tsipa/mh20-probe/hardware/pcb/check/report.txt

KiCad DRC (receiver_carrier.kicad_pcb): 0 item(s)
Extra checks: 0 violation(s)
Info: board_mm 98.00 x 70.00, vias 1, track_mm B.Cu=391.1 F.Cu=470.6, bodies 19
RESULT: PASS
