tsipa/mh20-probe/docs/images/no-probe.png

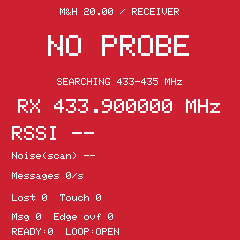
docs/images/no-probe.png
