tsipa/mh20-probe/docs/images/ready.png

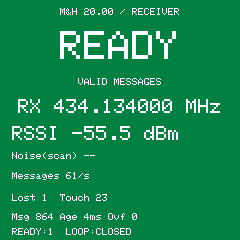
docs/images/ready.png
