tsipa/mh20-probe/hardware/pcb/preview/receiver_carrier-B_Cu.png

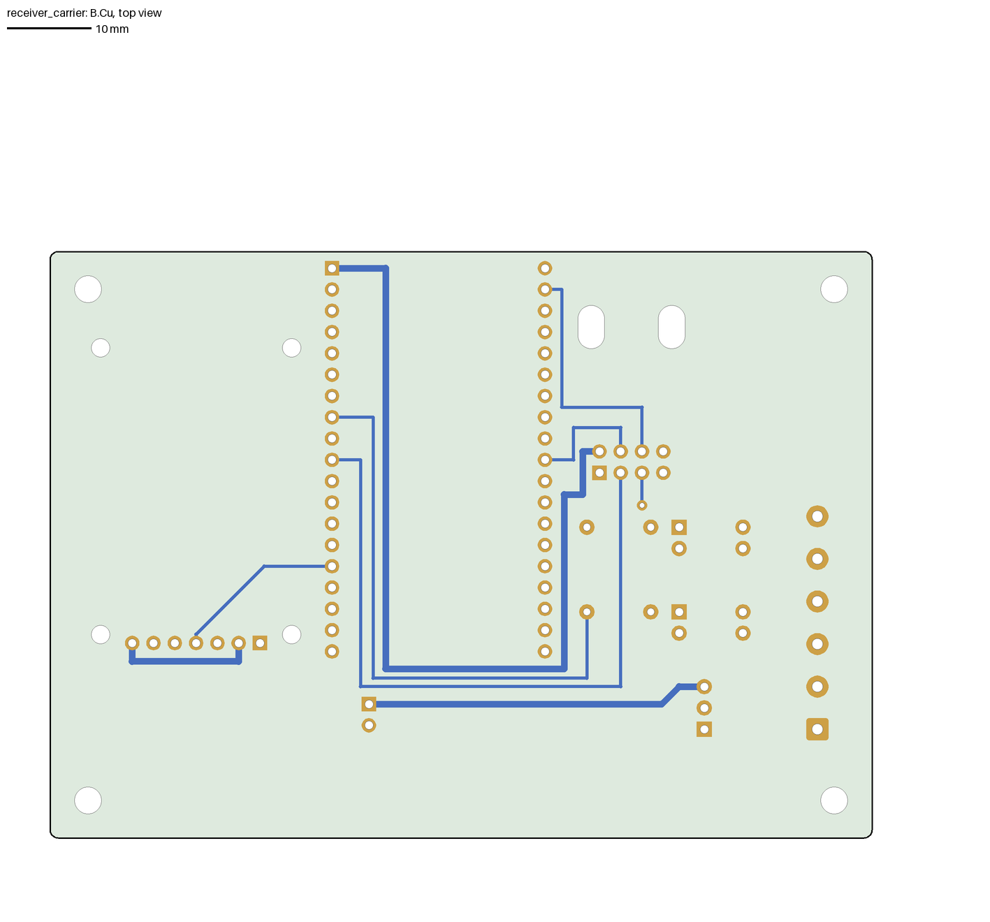
hardware/pcb/preview/receiver_carrier-B_Cu.png
