tsipa/mh20-probe/hardware/pcb/preview/receiver_carrier-back.png

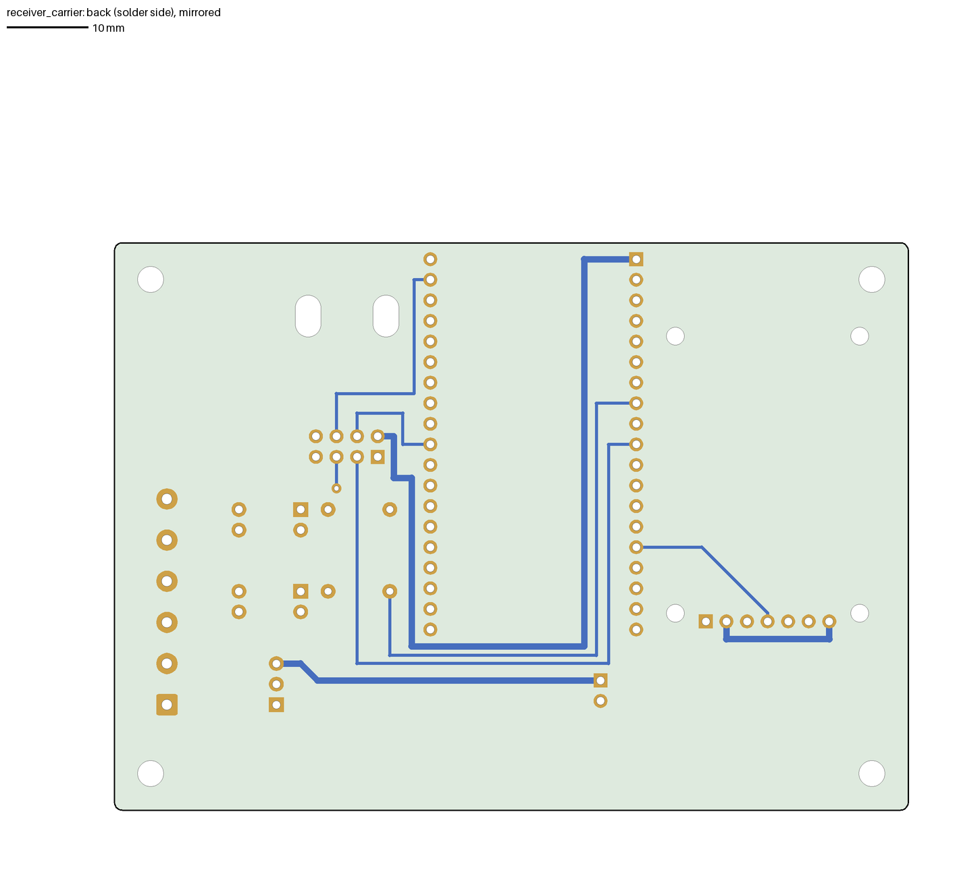
hardware/pcb/preview/receiver_carrier-back.png
