tsipa/mh20-probe/hardware/pcb/preview/receiver_carrier-F_Cu.png

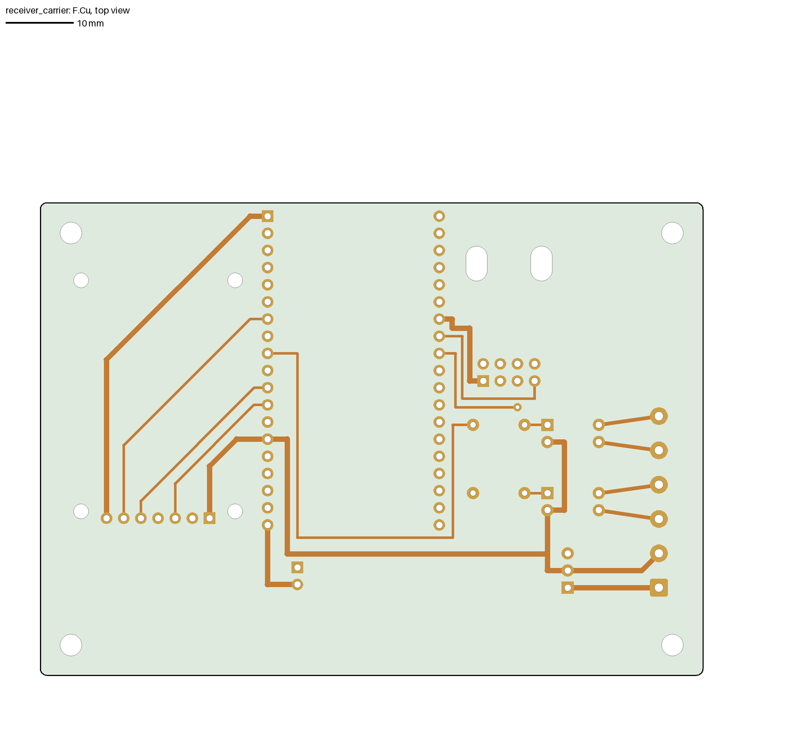
hardware/pcb/preview/receiver_carrier-F_Cu.png
