tsipa/mh20-probe/hardware/pcb/sources/CC1101-Product-size-600x313.jpg

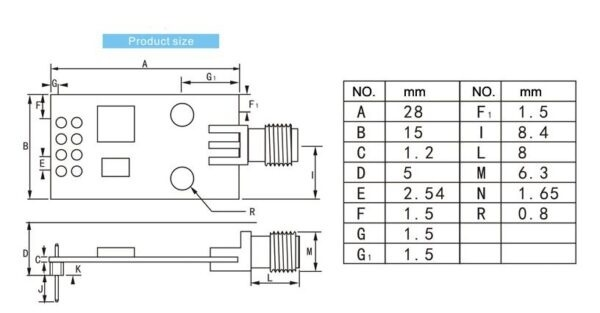
hardware/pcb/sources/CC1101-Product-size-600x313.jpg
