tsipa/mh20-probe/hardware/pcb/sources/er-tftm013-1_outline.webp

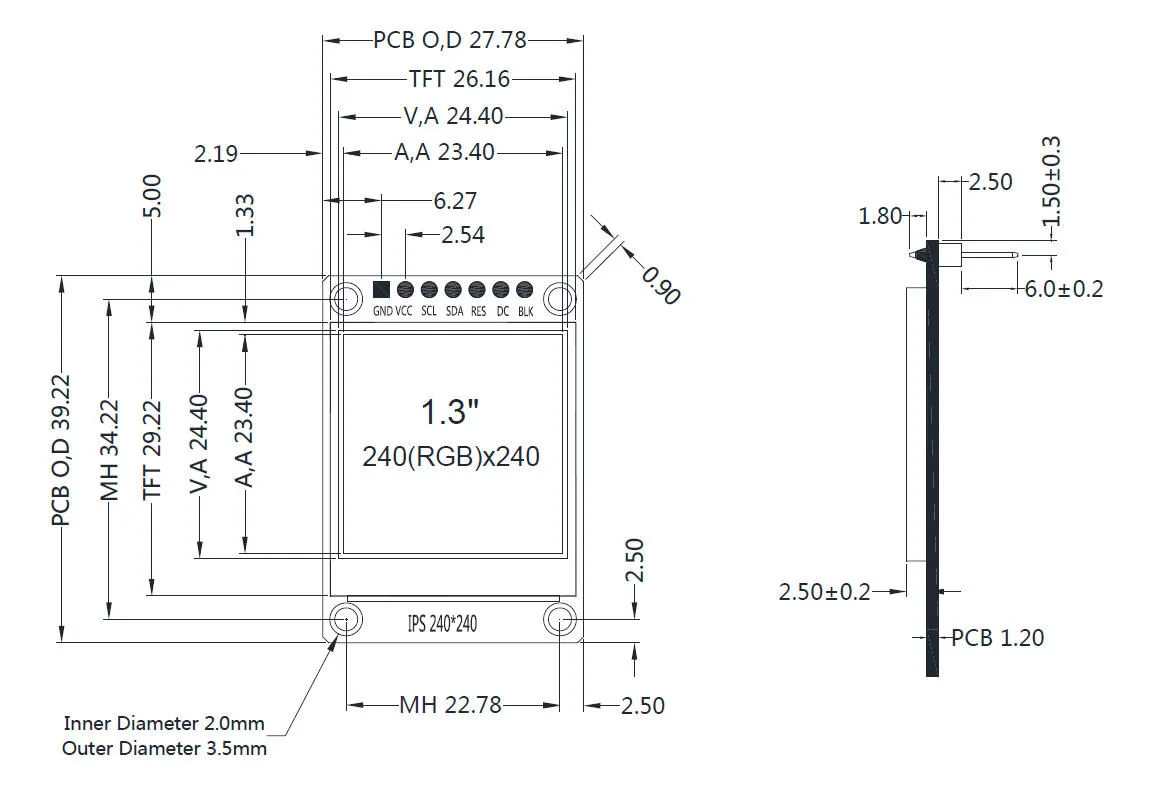
hardware/pcb/sources/er-tftm013-1_outline.webp
