tsipa/mh20-probe/hardware/pcb/sources/rf-ebyte-photo.jpg

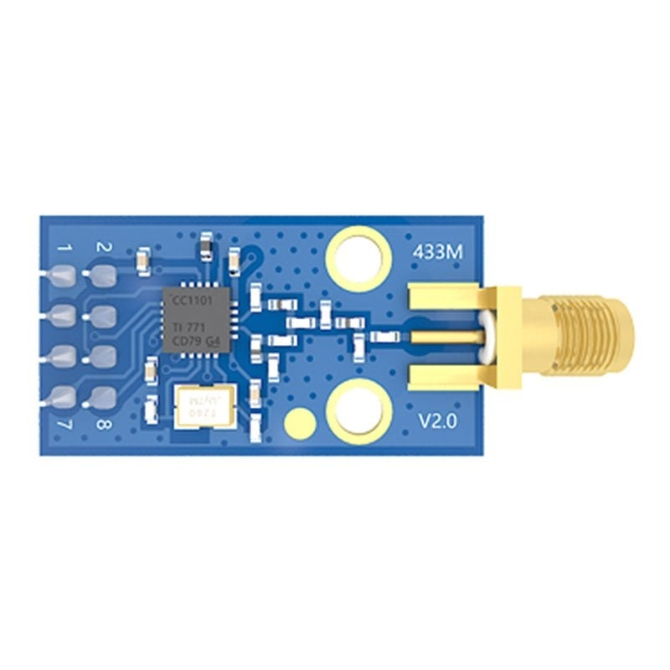
hardware/pcb/sources/rf-ebyte-photo.jpg
