tsipa/mh20-probe/hardware/pcb/sources/rf-spec-0.jpg

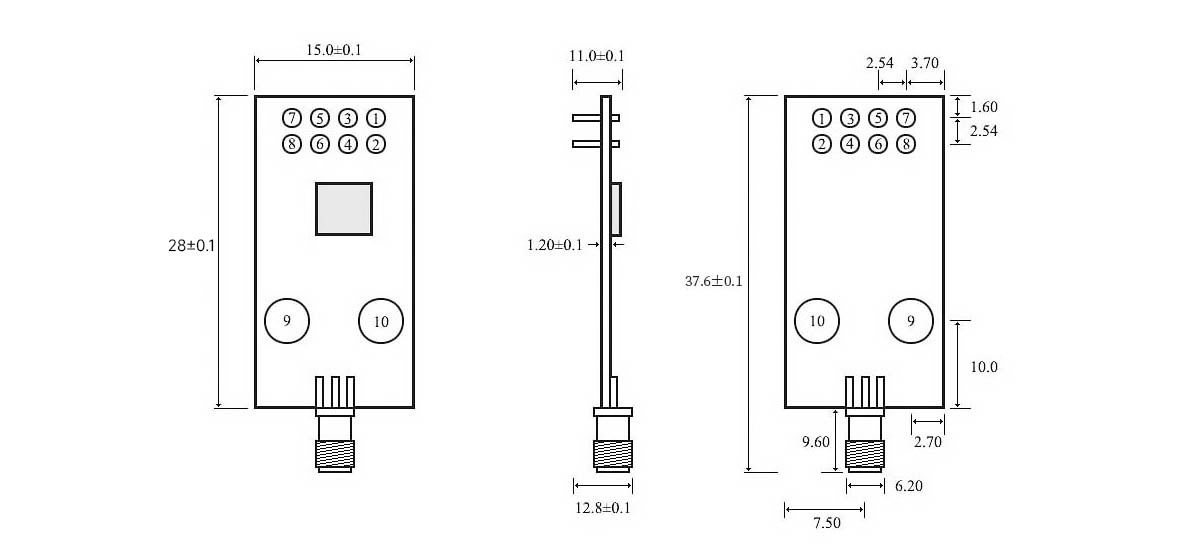
hardware/pcb/sources/rf-spec-0.jpg
