tsipa/mh20-probe/docs/images/wiring.png

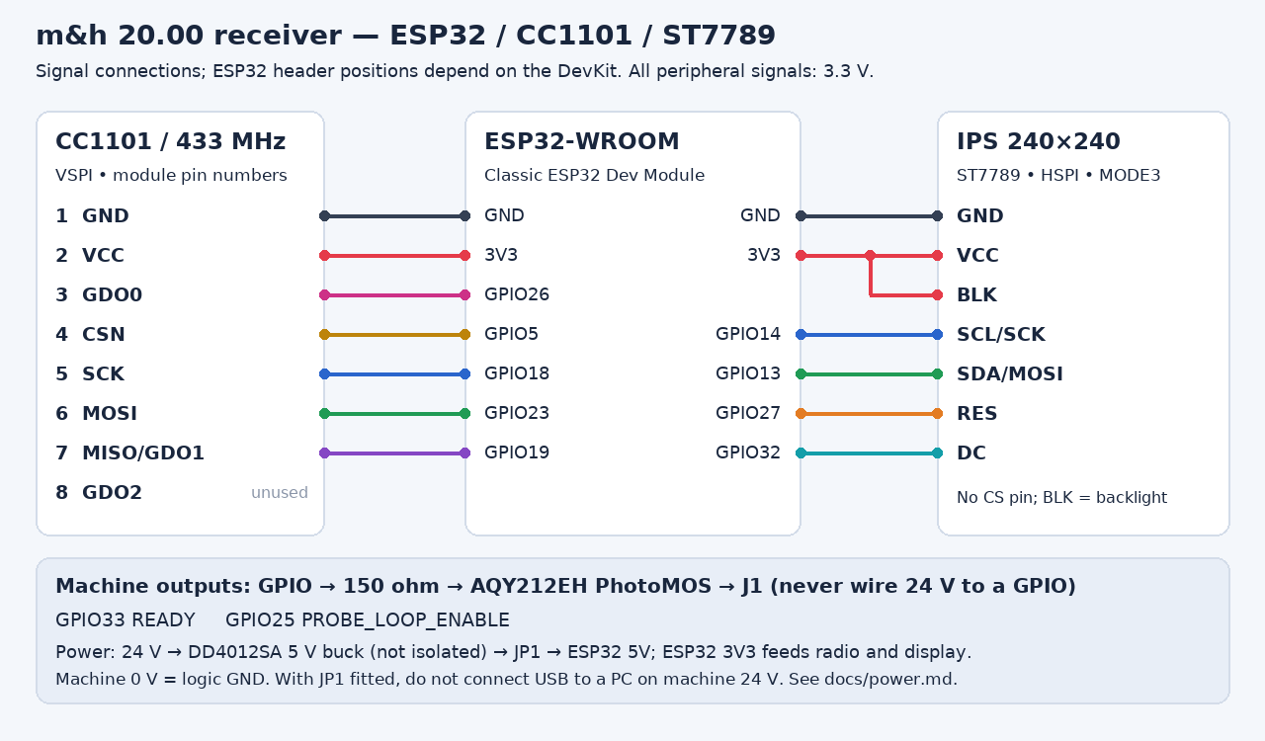
docs/images/wiring.png
