tsipa/mh20-probe/hardware/pcb/print/receiver_carrier-front-1to1.pdf

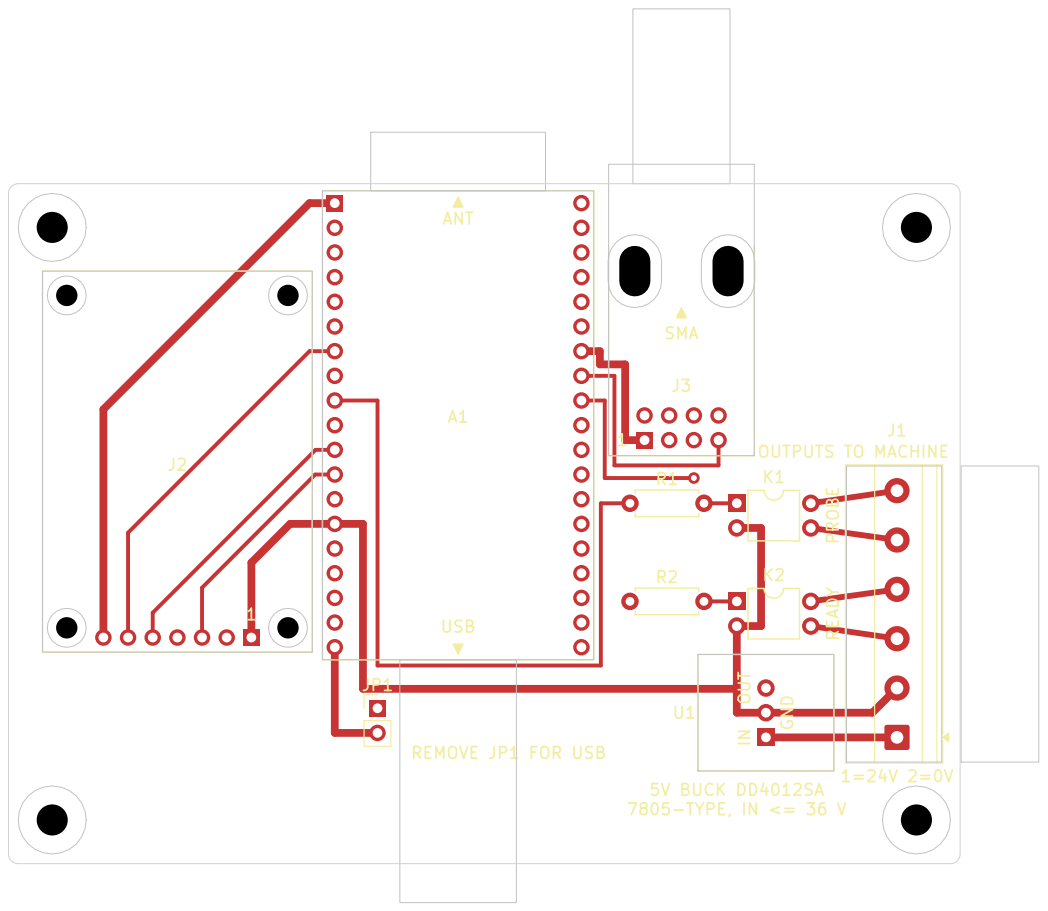
[picture p18: page 1]

5V BUCK DD4012SA 7805-TYPE, IN <= 36 V OUTPUTS TO MACHINE 1=24V 2=0V PROBE READY K2K1
