tsipa/mh20-probe/hardware/pcb/print/receiver_carrier-print-1to1.pdf

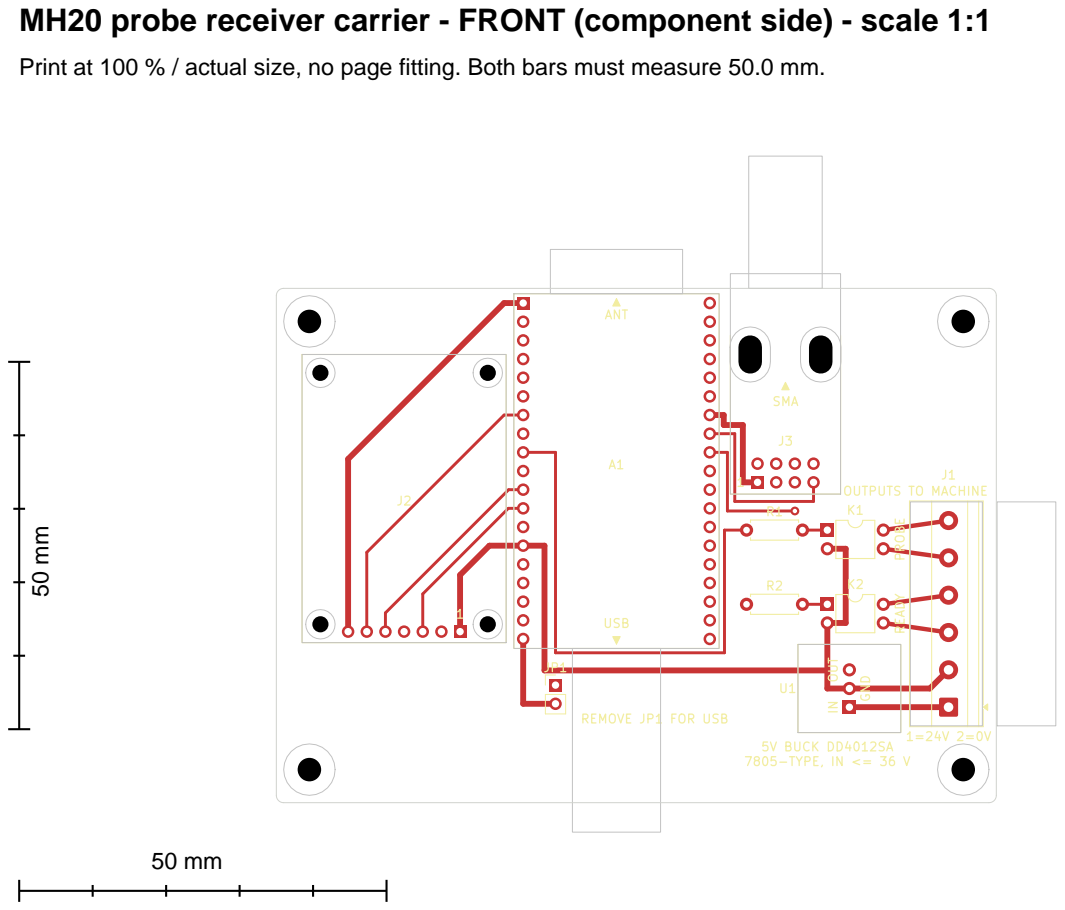
[picture p19: page 1]

MH20 probe receiver carrier - FRONT (component side) - scale 1:1

Print at 100 % / actual size, no page fitting. Both bars must measure 50.0 mm.

5V BUCK DD4012SA 7805-TYPE, IN <= 36 V OUTPUTS TO MACHINE 1=24V 2=0V PROBE READY K2K1

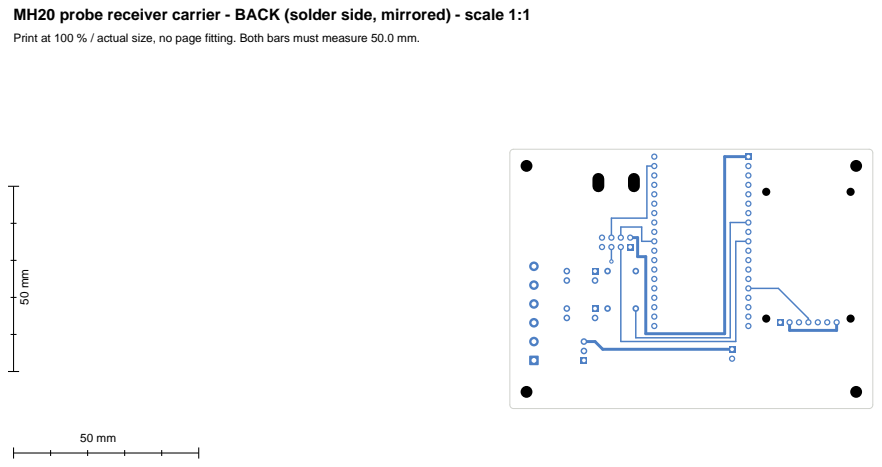
[picture p20: page 2]

MH20 probe receiver carrier - BACK (solder side, mirrored) - scale 1:1

Print at 100 % / actual size, no page fitting. Both bars must measure 50.0 mm.
