tsipa/mh20-probe/hardware/pcb/print/receiver_carrier-schematic.pdf

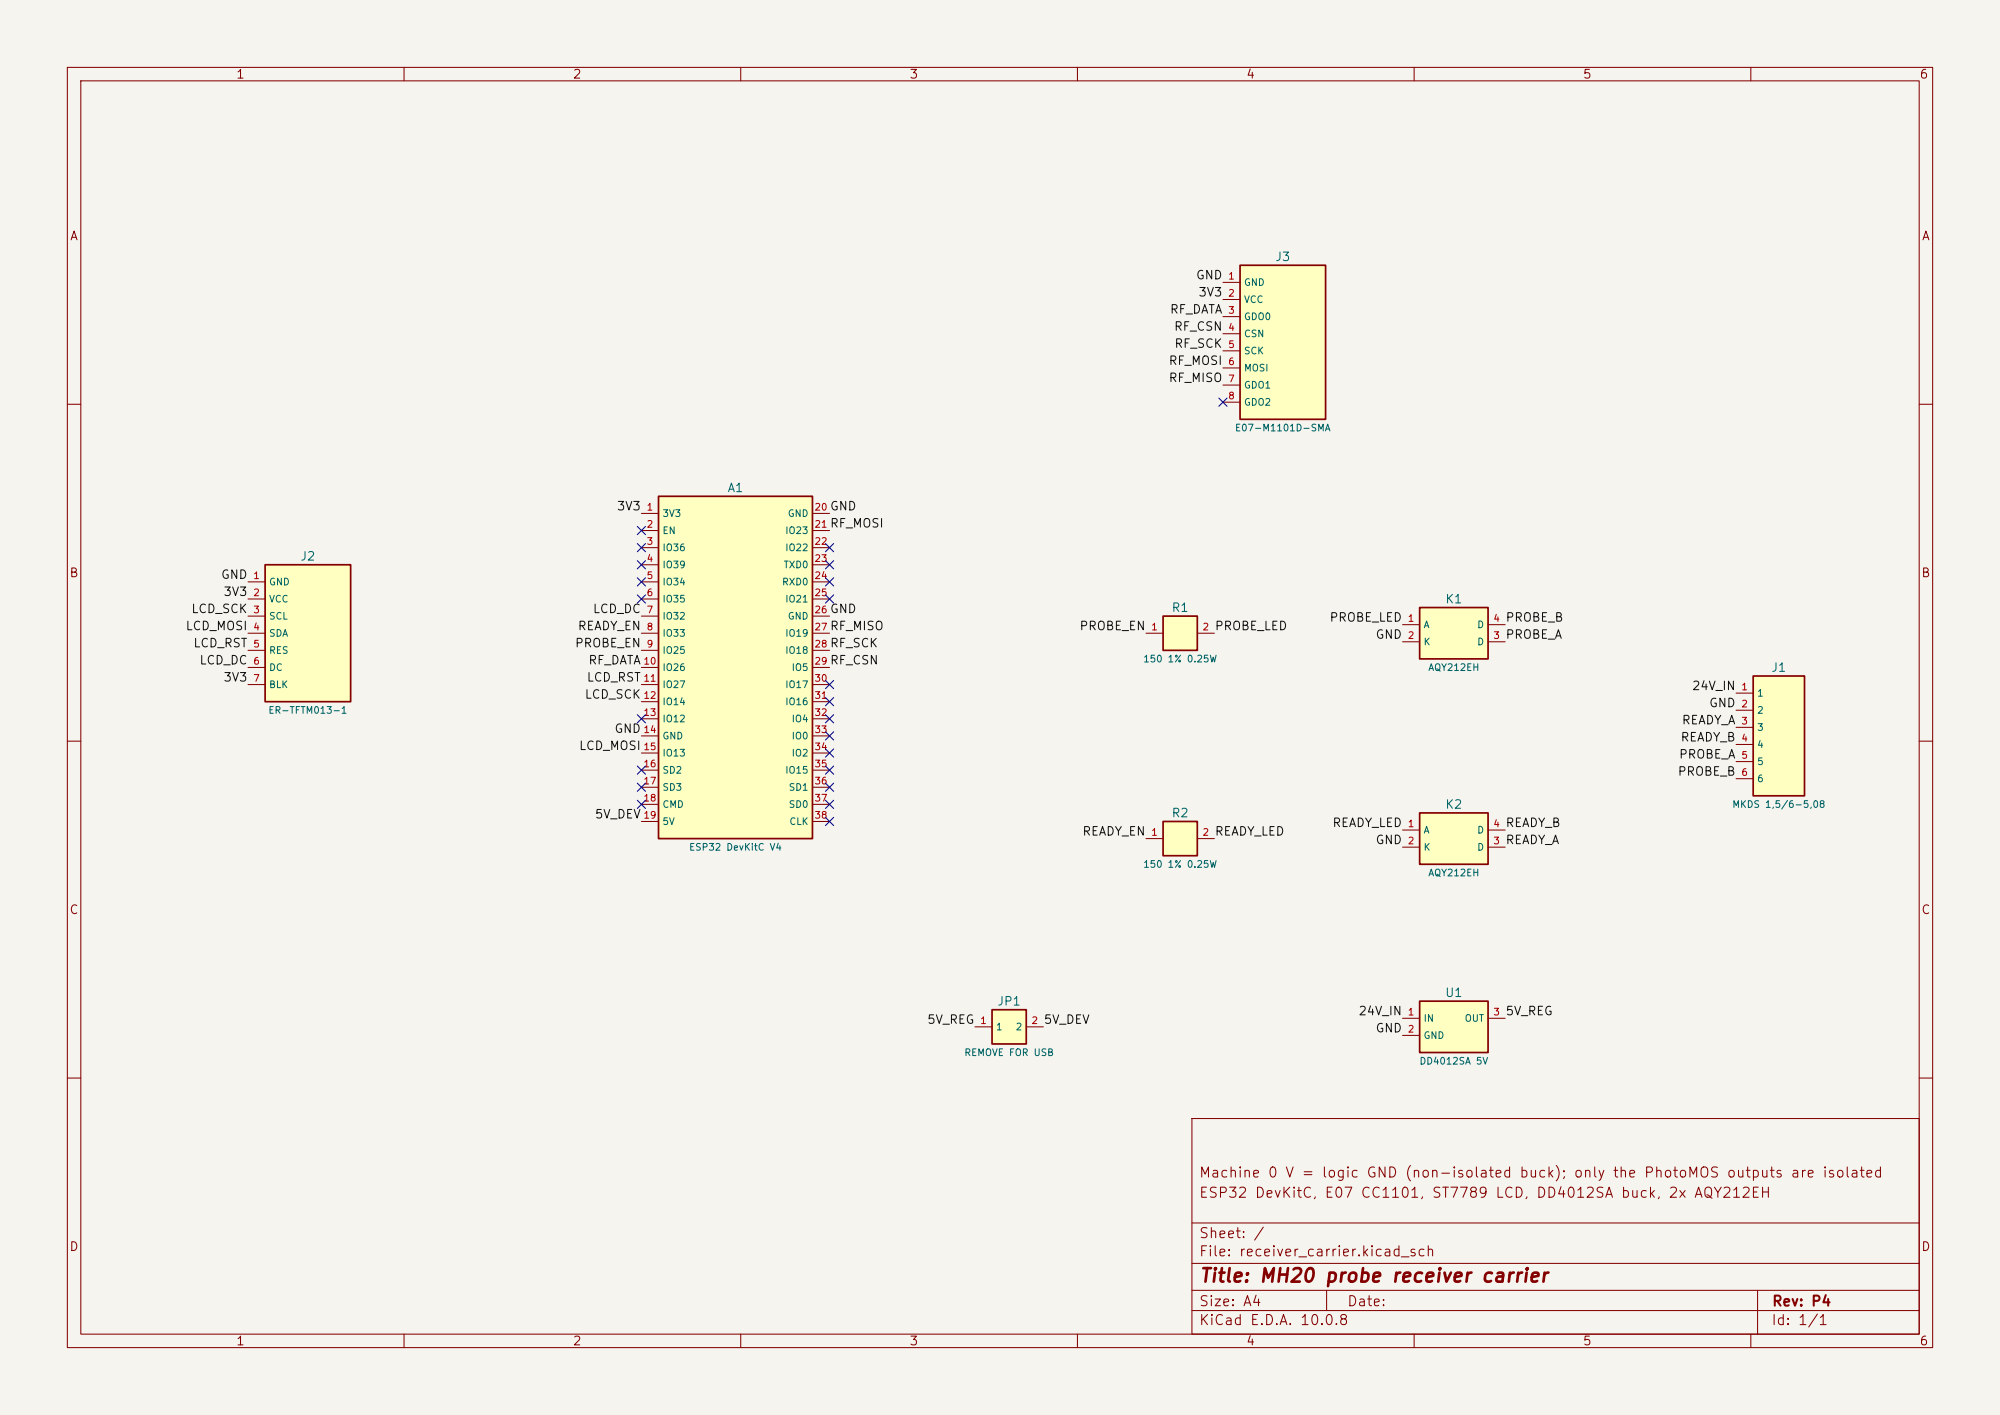
[picture p21: page 1]

Machine 0 V = logic GND (non-isolated buck); only the PhotoMOS outputs are isolated
ESP32 DevKitC, E07 CC1101, ST7789 LCD, DD4012SA buck, 2x AQY212EH

Sheet: /
File: receiver_carrier.kicad_sch
Title: MH20 probe receiver carrier

Size: A4 | Rev: P4
KiCad E.D.A. 10.0.8 | Id: 1/1
