tsipa/mh20-probe/hardware/pcb/print/receiver_carrier-back-1to1.pdf

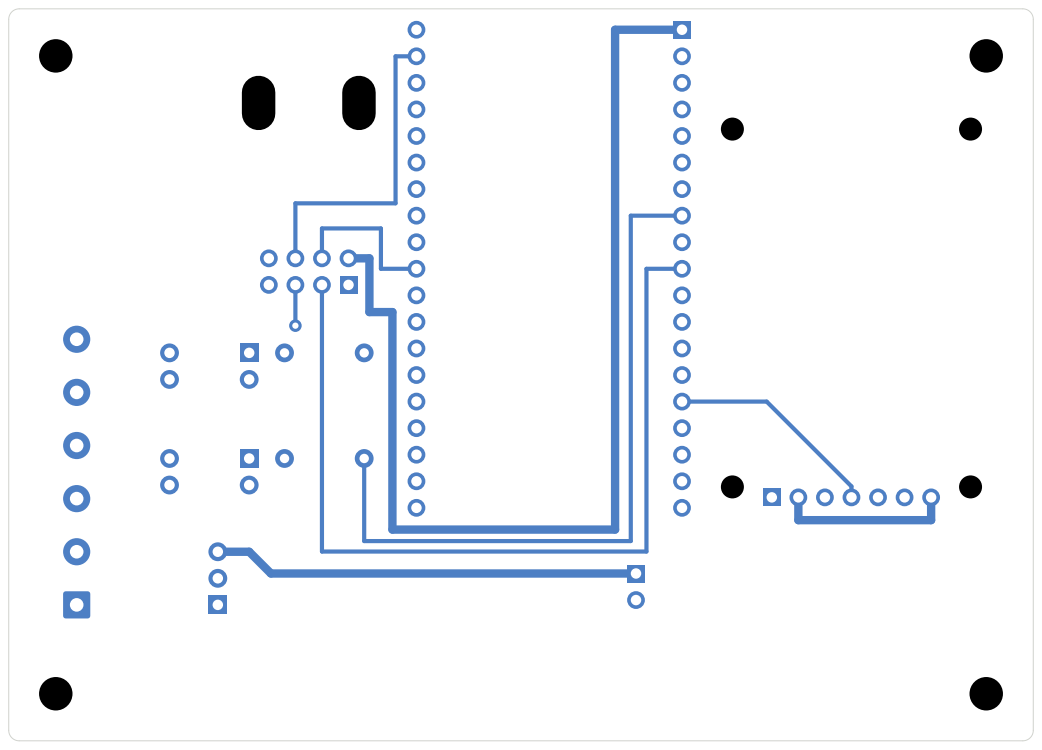
[picture p22: page 1]
