tsipa/mh20-probe/hardware/pcb/sources/esp32-devkitc-v4.pdf

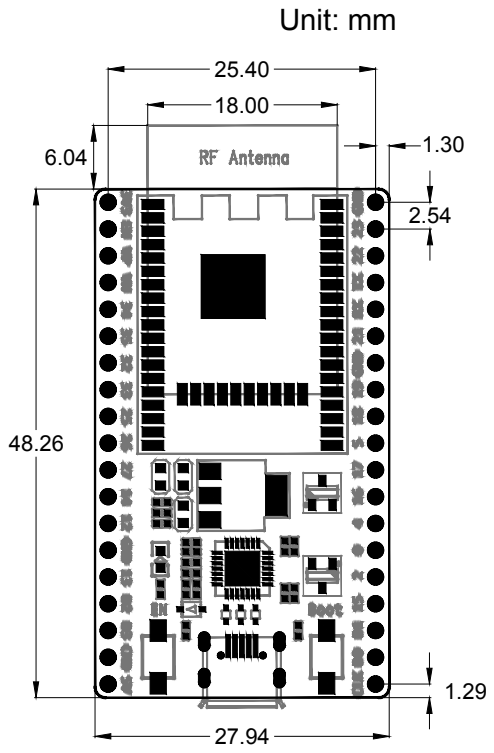
[picture p23: page 1]
1.30 Unit: mm
