tsipa/mh20-probe/hardware/pcb/receiver_carrier.kicad_pcb

## KiCad design hardware/pcb/receiver_carrier.kicad_pcb (2026-11-02)

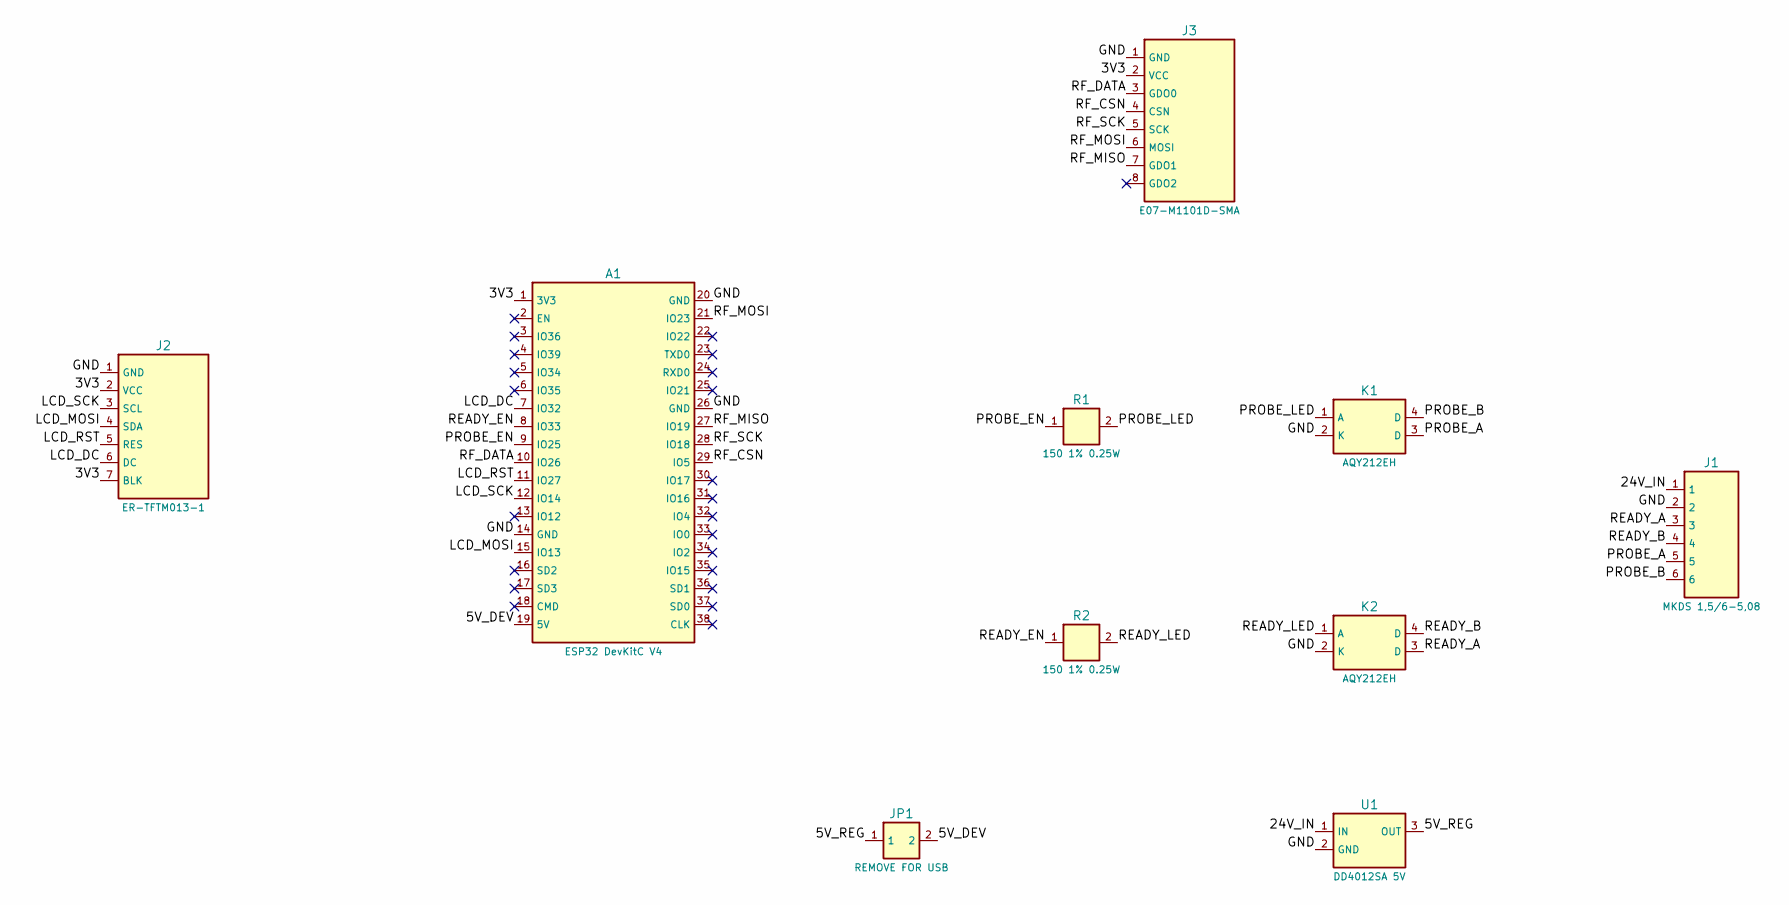
[picture p24: schematic receiver_carrier.kicad_sch, MH20 probe receiver carrier]

Parts:
A1: ESP32 DevKitC V4; esp32
J1: MKDS 1,5/6-5,08; TerminalBlock_Phoenix_MKDS-1,5-6-5.08_1x06_P5.08mm_Horizont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
J2: ER-TFTM013-1; lcd
J3: E07-M1101D-SMA; radio_e07
JP1: REMOVE FOR USB; PinHeader_1x02_P2.54mm_Vertical
K1, K2: AQY212EH; DIP-4_W7.62mm
R1, R2: 150 1% 0.25W; R_Axial_DIN0207_L6.3mm_D2.5mm_P7.62mm_Horizontal
U1: DD4012SA 5V; Buck_SIP3_7805

Connections:
/3V3: A1.1 (3V3), J2.2 (VCC), J2.7 (BLK), J3.2 (VCC)
/5V_DEV: A1.19 (5V), JP1.2
/5V_REG: JP1.1, U1.3 (OUT)
/24V_IN: J1.1, U1.1 (IN)
/GND: A1.14 (GND), A1.20 (GND), A1.26 (GND), J1.2, J2.1 (GND), J3.1 (GND), K1.2 (K), K2.2 (K), U1.2 (GND)
/LCD_DC: A1.7 (IO32), J2.6 (DC)
/LCD_MOSI: A1.15 (IO13), J2.4 (SDA)
/LCD_RST: A1.11 (IO27), J2.5 (RES)
/LCD_SCK: A1.12 (IO14), J2.3 (SCL)
/PROBE_A: J1.5, K1.3 (D)
/PROBE_B: J1.6, K1.4 (D)
/PROBE_EN: A1.9 (IO25), R1.1
/PROBE_LED: K1.1 (A), R1.2
/READY_A: J1.3, K2.3 (D)
/READY_B: J1.4, K2.4 (D)
/READY_EN: A1.8 (IO33), R2.1
/READY_LED: K2.1 (A), R2.2
/RF_CSN: A1.29 (IO5), J3.4 (CSN)
/RF_DATA: A1.10 (IO26), J3.3 (GDO0)
/RF_MISO: A1.27 (IO19), J3.7 (GDO1)
/RF_MOSI: A1.21 (IO23), J3.6 (MOSI)
/RF_SCK: A1.28 (IO18), J3.5 (SCK)

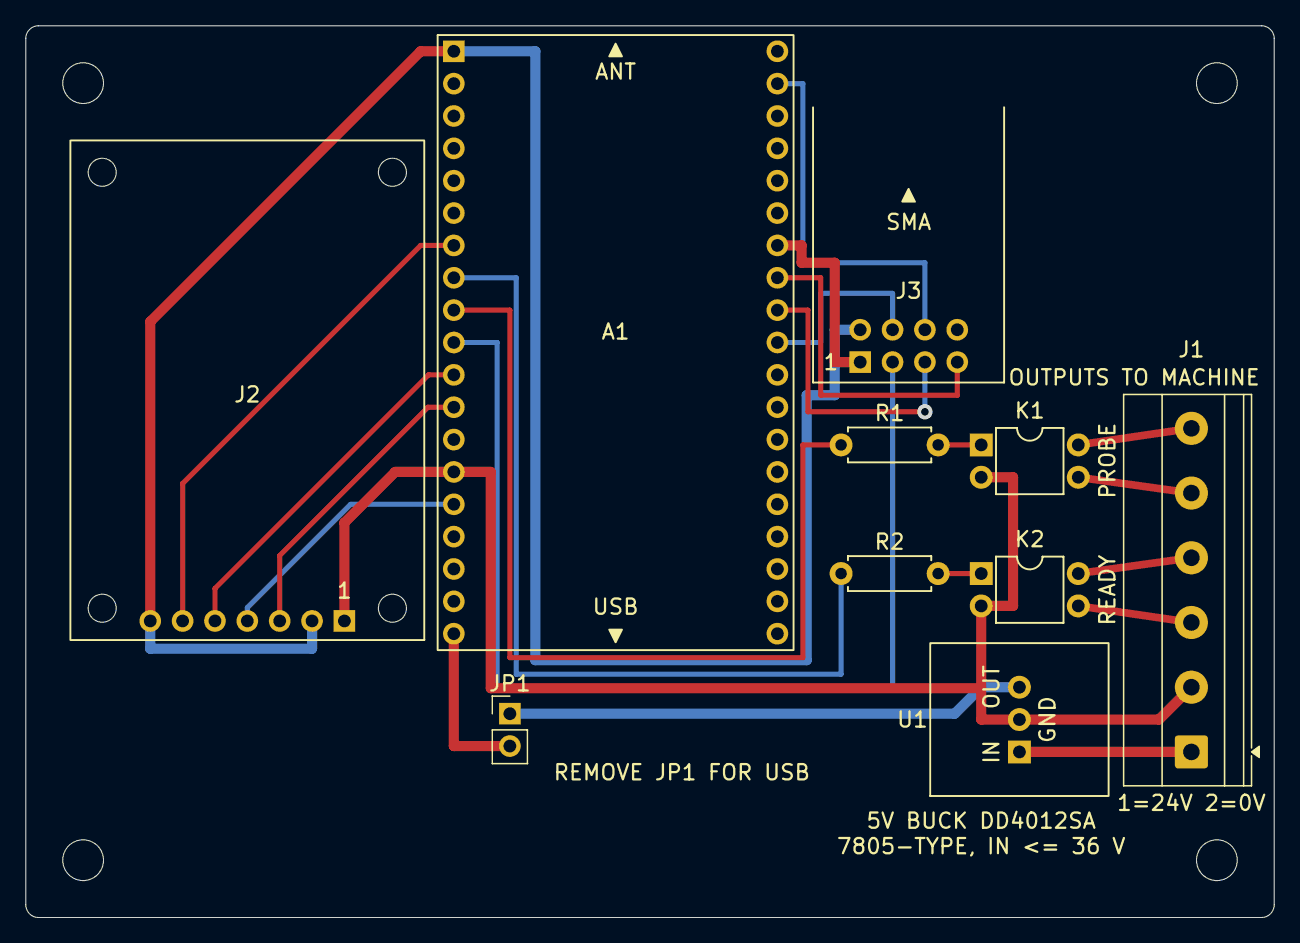
[picture p25: board receiver_carrier.kicad_pcb from above]

Board: 2 copper layers, 98.0 x 70.0 mm, 14 parts (0 on the bottom side), 22 nets.

Other parts of the board:
H1, H2, H3, H4: M3; Mount_M3
