tsipa/mh20-probe/(commit log)

2026-11-01 Add Wi-Fi service page and OTA with probe-detection shutdown
    [partitions.csv]
2026-11-01 Add router Wi-Fi, web and UART settings, and display connection status
2026-11-01 Add module-based receiver carrier prototype
    [bom.csv, receiver_carrier.kicad_pcb, receiver_carrier.kicad_sch]
2026-11-01 Select Pololu 5420 modules for isolated outputs
    [bom.csv, receiver_carrier.kicad_pcb, receiver_carrier.kicad_sch]
2026-11-02 Import P4 carrier design and receiver firmware improvements
    [bom.csv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]
